0x007E/pdb/mechanical/housing.FCStd

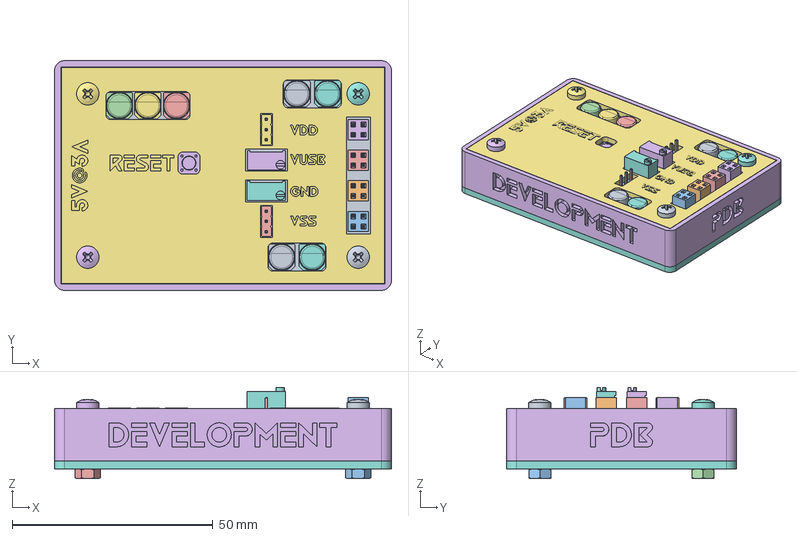
[picture p1: CAD file, 2026-11-11]
mechanical/housing.FCStd
83.9 x 57.2 x 22.7 mm
Pcb_f740
R37_R_1206_3216Metric_8dc8d8b837c7
D7_LED_1206_3216Metric_03436d3d43b0
C1_CP_Elec_63x59_ac60a408893e
J6_PinHeader_1x03_P254mm_Vertical_e7fe031d61e9
SW1_SW_SPST_PTS645_56072588c5ee
J7_PinHeader_1x03_P254mm_Vertical_64817d6dd410
C18_CP_Elec_63x59_f49aa5442a44
R33_R_1206_3216Metric_79ca62f361a1
R27_R_1206_3216Metric_e86c5854c73b
R11_R_1206_3216Metric_0498128ec142
C28_C_1206_3216Metric_f00f97c33d81
USB4110-GF-A_PART1
U13_SOIC-14_3.9x8.7mm_P1.27mm_fcffda3dd498
D11_LED_RGB_5050_6_532df4f6e047
U12_SOIC-20W_7.5x12.8mm_P1.27mm_03fbeaa8a600
C17_CP_Elec_63x59_3dc60d15017d
C14_C_1206_3216Metric_c0d112c57c42
U7_SOT-23-6_0d97033324a5
R31_R_1206_3216Metric_8311e07fb539
R32_R_0603_1608Metric_86467d0f25c6
R16_R_1206_3216Metric_bbbf9209e873
D8_LED_1206_3216Metric_1083185e3bac
C23_C_1206_3216Metric_63c05ad9d92d
C27_C_1206_3216Metric_64f8ffbf20c3
R30_R_1206_3216Metric_f399efe9705c
R7_R_1206_3216Metric_ecda7ad82412
FB1_L_1206_3216Metric_9c7c14a58714
C12_C_1206_3216Metric_c5a151fd8f46
J2_PinSocket_2x02_P2.54mm_Vertical_089ed923d5fd
R36_R_1206_3216Metric_7b1d4e33c85c
RV1_Potentiometer_Bourns_3296W_Vertical_0824b710e74b
R10_R_1206_3216Metric_e1003af8b17f
C7_C_1206_3216Metric_26ba6747aed6
C3_C_1206_3216Metric_682e178fab99
U6_SOT-23_129ab226013d
J3_PinSocket_2x02_P2.54mm_Vertical_d789eb4625c0
C21_C_1206_3216Metric_de8a52bde034
C22_CP_EIA_3528_21_Kemet_B_923ea54f02e1
C20_CP_Elec_63x59_be447e37ad13
C19_CP_Elec_63x59_ce8c8bccf6d3
D10_LED_RGB_5050_6_c19e5f31c3e7
J5_PinSocket_2x02_P2.54mm_Vertical_2282c8bdb4fb
U2_SOT-23-5_23668840369d
U4_SOT-23_160a322001ac
RV2_Potentiometer_Bourns_3296W_Vertical_1dc8002d6194
C2_CP_Elec_63x59_3be86c793b43
R35_R_0603_1608Metric_fd289fbd0296
R14_R_1206_3216Metric_f30b6a69329d
J4_PinSocket_2x02_P2.54mm_Vertical_daca4fe0ad83
F1_Fuse_1206_3216Metric_cb2e88f19b03
R25_R_1206_3216Metric_96075576e4a0
C4_CP_Elec_63x59_df56ed045cb5
U5_SOT-23-6_a3420cd51542
D9_LED_RGB_5050_6_6b2e14bdcd41
R13_R_1206_3216Metric_f45467d9409e
U8_SOT-23_cd022fe481a0
R1_R_1206_3216Metric_fea3697b2820
R24_R_1206_3216Metric_01efbf579b95
R19_R_1206_3216Metric_e2651890cbbe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
