0x007E/pdb/pcb/PDB.kicad_pcb

## KiCad design pcb/PDB.kicad_pcb (2026-10-15)

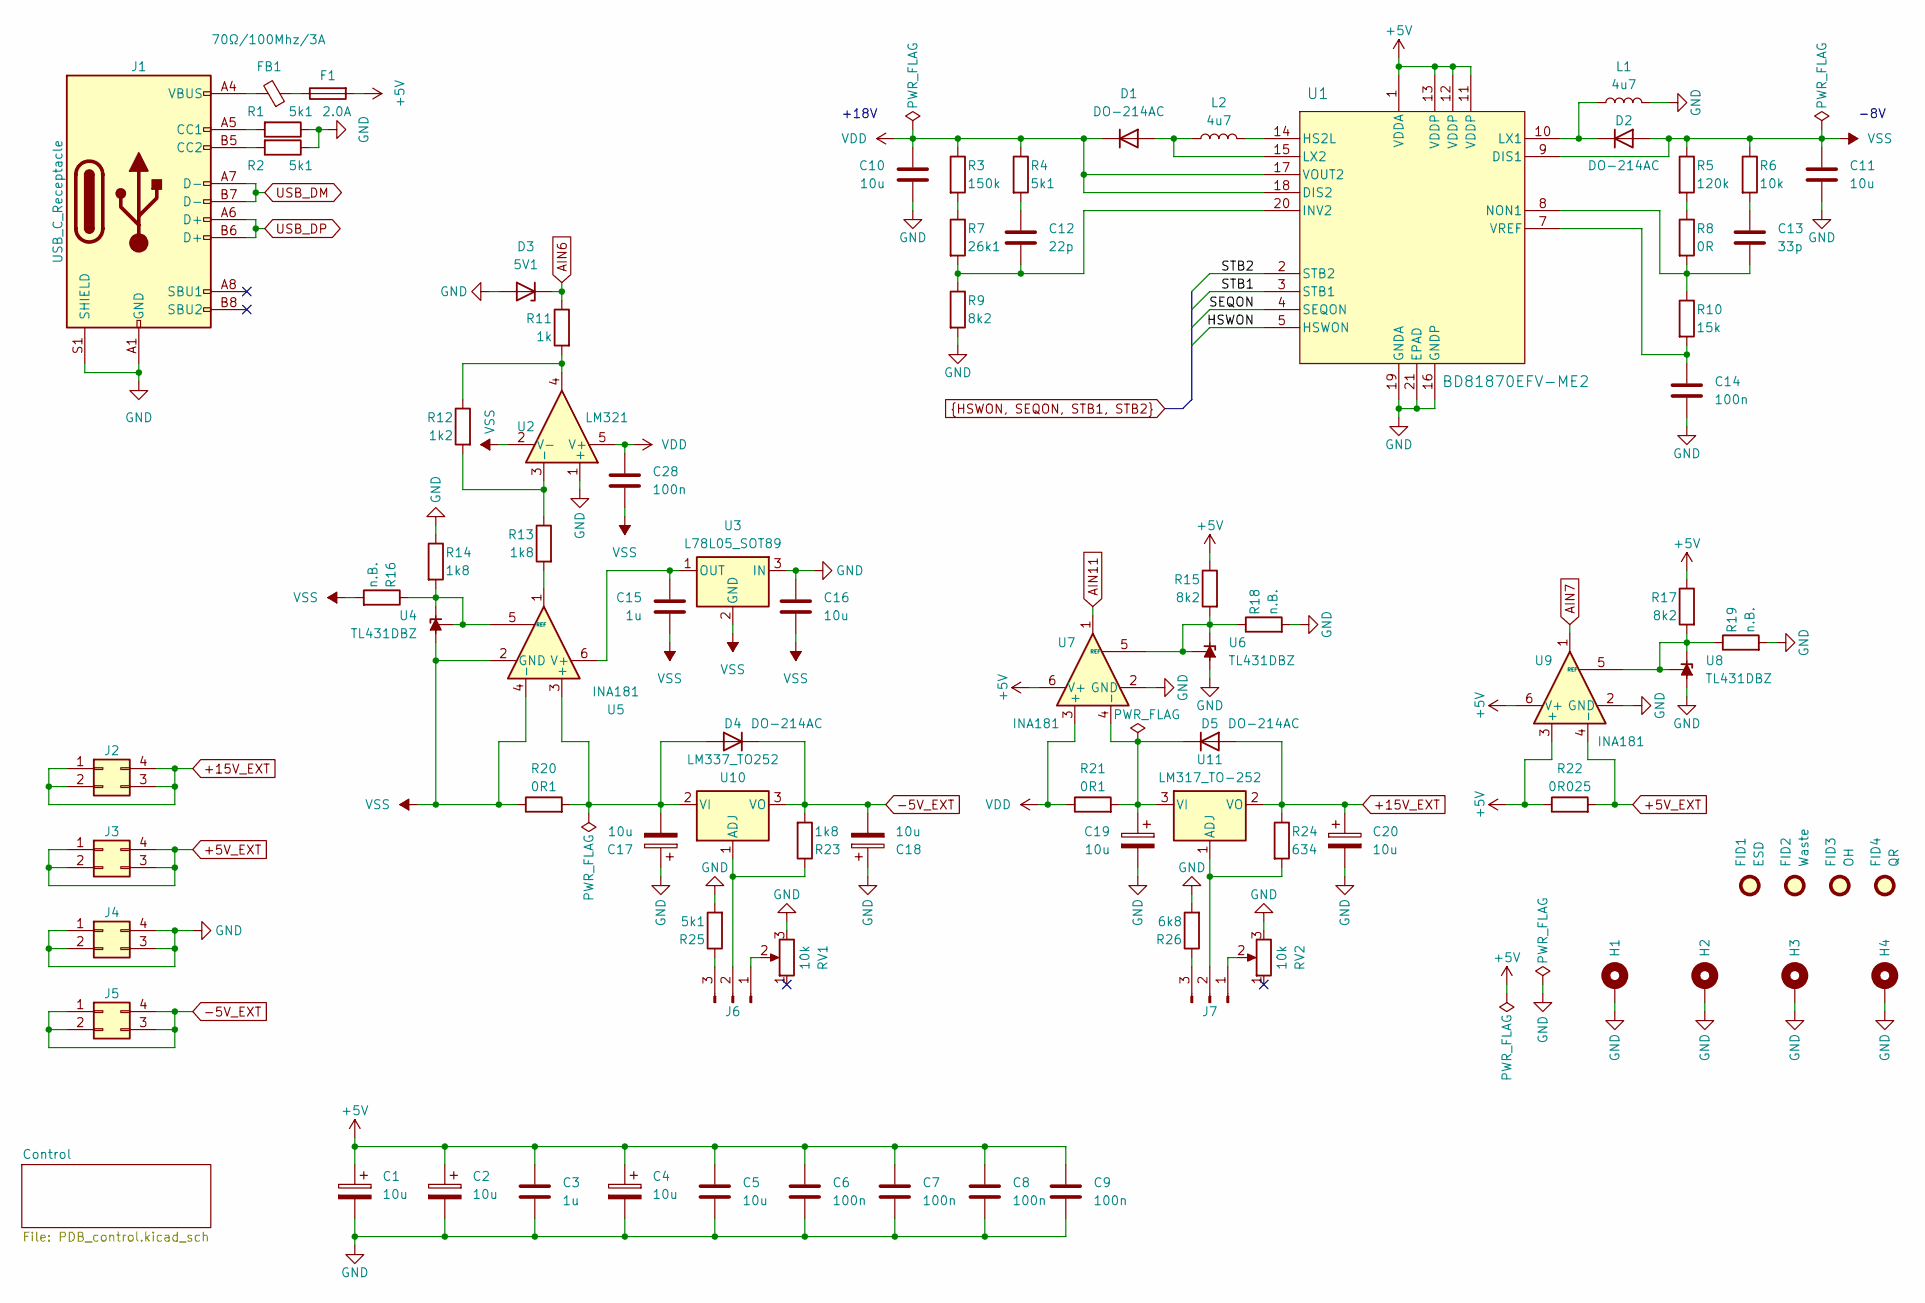
[picture p2: schematic PDB.kicad_sch, ${acronym} - ${title}]

Parts:
C1, C2, C4, C17, C18, C19, C20: 10u; CP_Elec_6.3x5.9; DigiKey 732-8545-1-ND
C3, C15: 1u; C_1206_3216Metric
C5, C10, C11, C16: 10u; C_1206_3216Metric
C6, C7, C8, C9, C14, C28: 100n; C_1206_3216Metric
C12: 22p; C_1206_3216Metric
C13: 33p; C_1206_3216Metric
D1, D2, D4, D5: DO-214AC; D_SMA
D3: 5V1; D_MiniMELF
F1: 2.0A; Fuse_1206_3216Metric
FB1: 70Ω/100Mhz/3A; L_1206_3216Metric
FID1: ESD; ESD-Logo_6.6x6mm_SilkScreen
FID2: Waste; WEEE-Logo_4.2x6mm_SilkScreen
FID3: OH; OSHW-Logo_5.7x6mm_SilkScreen
FID4: QR; QR_0x007e
H1, H2, H3, H4: MountingHole_Pad; MountingHole_3.2mm_M3_Pad
J1: USB_C_Receptacle; USB_C_Receptacle_GCT_USB4110
J2, J3, J4, J5: Conn_02x02_Counter_Clockwise; PinSocket_2x02_P2.54mm_Vertical; DigiKey 2057-RS2-04-G-ND
J6, J7: Conn_01x03_Pin; PinHeader_1x03_P2.54mm_Vertical
L1, L2: 4u7; L_Taiyo-Yuden_NR-40xx; DigiKey 587-2893-1-ND
R1, R2, R4, R25: 5k1; R_1206_3216Metric
R3: 150k; R_1206_3216Metric
R5: 120k; R_1206_3216Metric
R6: 10k; R_1206_3216Metric
R7: 26k1; R_1206_3216Metric
R8: 0R; R_1206_3216Metric
R9, R15, R17: 8k2; R_1206_3216Metric
R10: 15k; R_1206_3216Metric
R11: 1k; R_1206_3216Metric
R12: 1k2; R_1206_3216Metric
R13, R14, R23: 1k8; R_1206_3216Metric
R16, R18, R19: n.B.; R_1206_3216Metric
R20, R21: 0R1; R_2010_5025Metric; DigiKey CRM2010-FX-R100ELFCT-ND
R22: 0R025; R_2010_5025Metric
R24: 634; R_1206_3216Metric
R26: 6k8; R_1206_3216Metric
RV1, RV2: 10k; Potentiometer_Bourns_3296W_Vertical
U1: BD81870EFV-ME2; HTSSOP-20-1EP_4.4x6.5mm_P0.65mm_EP2.85x4mm; DigiKey BD81870EFV-ME2CT-ND
U2: LM321; SOT-23-5; DigiKey LM321SN3T1GOSCT-ND
U3: L78L05_SOT89; SOT-89-3
U4, U6, U8: TL431DBZ; SOT-23; DigiKey 5399-TL431CT-ND
U5, U7, U9: INA181; SOT-23-6
U10: LM337_TO252; TO-252-2; DigiKey 296-21578-1-ND
U11: LM317_TO-252; TO-252-2; DigiKey 5272-LM317MDT-EVCT-ND

Connections:
+5V: C1.1, C2.1, C3.1, C4.1, C5.1, C6.1, C7.1, C8.1, C9.1, F1.2, R15.1, R17.1, R22.1, U1.1 (VDDA), U1.11 (VDDP), U1.12 (VDDP), U1.13 (VDDP), U7.6 (V+), U9.3 (+), U9.6 (V+); also elsewhere on the board
+5V_EXT: J3.1, J3.2, J3.3, J3.4, R22.2, U9.4 (-); also elsewhere on the board
+15V_EXT: C20.1, D5.2 (A), J2.1, J2.2, J2.3, J2.4, R24.1, U11.2 (VO); also elsewhere on the board
-5V_EXT: C18.2, D4.1 (K), J5.1, J5.2, J5.3, J5.4, R23.2, U10.3 (VO); also elsewhere on the board
AIN6: D3.1 (K), R11.1; also elsewhere on the board
AIN7: U9.1; also elsewhere on the board
AIN11: U7.1; also elsewhere on the board
GND: C1.2, C2.2, C3.2, C4.2, C5.2, C6.2, C7.2, C8.2, C9.2, C10.1, C11.1, C14.1, C16.2, C17.1, C18.1, C19.2, C20.2, D3.2 (A), H1.1, H2.1, H3.1, H4.1, J1.A1 (GND), J1.A12 (GND), J1.B1 (GND), J1.B12 (GND), J1.S1 (SHIELD), J4.1, J4.2, J4.3, J4.4, L1.2, R1.1, R2.1, R9.2, R14.1, R18.2, R19.2, R25.2, R26.2, RV1.3, RV2.3, U1.16 (GNDP), U1.19 (GNDA), U1.21 (EPAD), U2.1 (+), U3.3 (IN), U6.3 (A), U7.2 (GND), U8.3 (A), U9.2 (GND); also elsewhere on the board
HSWON: U1.5 (HSWON); also elsewhere on the board
unnamed: C12.1, R4.2
unnamed: C13.2, R6.2
unnamed: D1.2 (A), L2.1, U1.15 (LX2)
unnamed: D2.1 (K), L1.1, U1.10 (LX1)
unnamed: C17.2, D4.2 (A), R20.2, U5.3 (+), U10.2 (VI)
unnamed: C19.1, D5.1 (K), R21.2, U7.4 (-), U11.3 (VI)
unnamed: F1.1, FB1.1
unnamed: FB1.2, J1.A4 (VBUS), J1.A9 (VBUS), J1.B4 (VBUS), J1.B9 (VBUS)
unnamed: J1.A5 (CC1), R1.2
unnamed: J1.B5 (CC2), R2.2
unnamed: J6.1, RV1.2
unnamed: J6.2, R23.1, U10.1 (ADJ)
unnamed: J6.3, R25.1
unnamed: J7.1, RV2.2
unnamed: J7.2, R24.2, U11.1 (ADJ)
unnamed: J7.3, R26.1
unnamed: R3.2, R7.1
unnamed: R5.2, R8.1
unnamed: R11.2, R12.1, U2.4
unnamed: R13.2, U5.1
unnamed: L2.2, U1.14 (HS2L)
unnamed: C12.2, R7.2, R9.1, U1.20 (INV2)
unnamed: C13.1, R8.2, R10.1, U1.8 (NON1)
unnamed: C14.2, R10.2, U1.7 (VREF)
unnamed: R12.2, R13.1, U2.3 (-)
unnamed: C15.2, U3.1 (OUT), U5.6 (V+)
unnamed: R14.2, R16.1, U4.1 (K), U4.2 (REF), U5.5 (REF)
unnamed: R15.2, R18.1, U6.1 (K), U6.2 (REF), U7.5 (REF)
unnamed: R17.2, R19.1, U8.1 (K), U8.2 (REF), U9.5 (REF)
SEQON: U1.4 (SEQON); also elsewhere on the board
STB1: U1.3 (STB1); also elsewhere on the board
STB2: U1.2 (STB2); also elsewhere on the board
USB_DM: J1.A7 (D-), J1.B7 (D-); also elsewhere on the board
USB_DP: J1.A6 (D+), J1.B6 (D+); also elsewhere on the board
VDD: C10.2, C28.1, D1.1 (K), R3.1, R4.1, R21.1, U1.17 (VOUT2), U1.18 (DIS2), U2.5 (V+), U7.3 (+)
VSS: C11.2, C15.1, C16.1, C28.2, D2.2 (A), R5.1, R6.1, R16.2, R20.1, U1.9 (DIS1), U2.2 (V-), U3.2 (GND), U4.3 (A), U5.2 (GND), U5.4 (-)

Notes on the sheet:
-8V
+18V

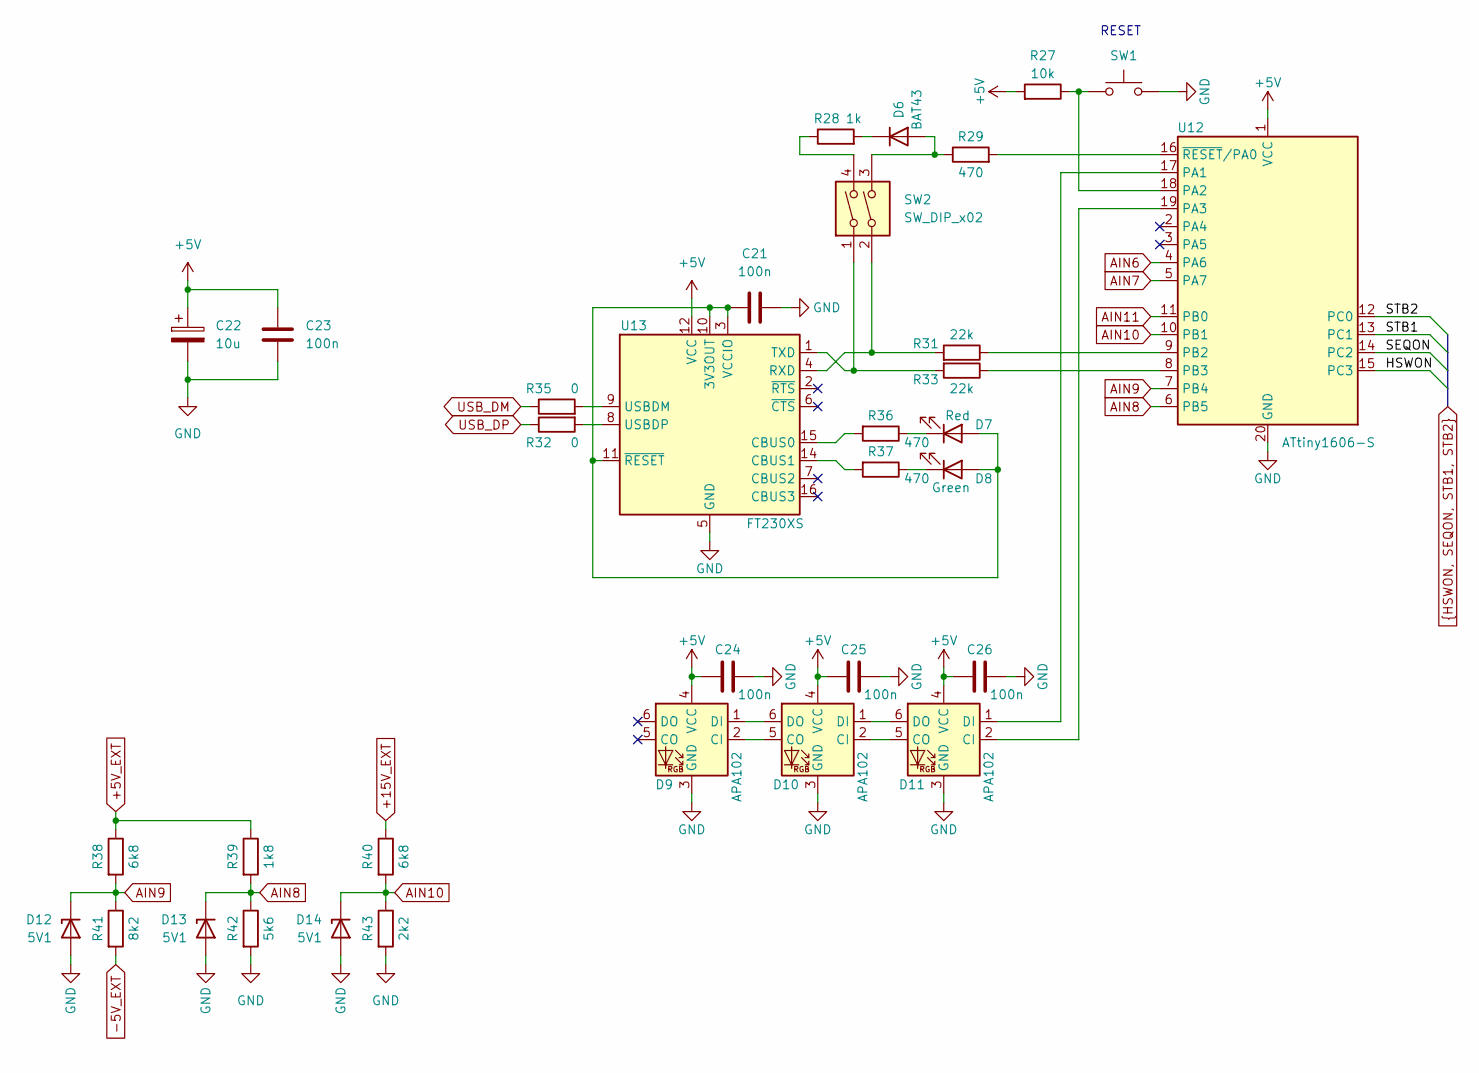
[picture p3: schematic PDB_control.kicad_sch, ${acronym} - ${title}]

Parts:
C21, C23, C24, C25, C26: 100n; C_1206_3216Metric
C22: 10u; CP_EIA-3528-21_Kemet-B
D6: BAT43; D_MiniMELF
D7: Red; LED_1206_3216Metric
D8: Green; LED_1206_3216Metric
D9, D10, D11: APA102; LED_RGB_5050-6
D12, D13, D14: 5V1; D_MiniMELF
R27: 10k; R_1206_3216Metric
R28: 1k; R_1206_3216Metric
R29, R36, R37: 470; R_1206_3216Metric
R31, R33: 22k; R_1206_3216Metric
R32, R35: 0; R_0603_1608Metric; DigiKey RMCF0603ZT0R00CT-ND
R38, R40: 6k8; R_1206_3216Metric
R39: 1k8; R_1206_3216Metric
R41: 8k2; R_1206_3216Metric
R42: 5k6; R_1206_3216Metric
R43: 2k2; R_1206_3216Metric
SW1: SW_Push; SW_SPST_PTS645
SW2: SW_DIP_x02; SW_DIP_SPSTx02_Slide_6.7x6.64mm_W8.61mm_P2.54mm_LowProfile
U12: ATtiny1606-S; SOIC-20W_7.5x12.8mm_P1.27mm
U13: FT230XS; SSOP-16_3.9x4.9mm_P0.635mm

Connections:
+5V: C22.1, C23.1, C24.2, C25.2, C26.2, D9.4 (VCC), D10.4 (VCC), D11.4 (VCC), R27.2, U12.1 (VCC), U13.12 (VCC); also elsewhere on the board
+5V_EXT: R38.1, R39.1; also elsewhere on the board
+15V_EXT: R40.1; also elsewhere on the board
-5V_EXT: R41.2; also elsewhere on the board
AIN6: U12.4 (PA6); also elsewhere on the board
AIN7: U12.5 (PA7); also elsewhere on the board
AIN8: D13.1 (K), R39.2, R42.1, U12.6 (PB5)
AIN9: D12.1 (K), R38.2, R41.1, U12.7 (PB4)
AIN10: D14.1 (K), R40.2, R43.1, U12.10 (PB1)
AIN11: U12.11 (PB0); also elsewhere on the board
GND: C21.2, C22.2, C23.2, C24.1, C25.1, C26.1, D9.3 (GND), D10.3 (GND), D11.3 (GND), D12.2 (A), D13.2 (A), D14.2 (A), R42.2, R43.2, SW1.1, U12.20 (GND), U13.5 (GND), U13.13 (GND); also elsewhere on the board
HSWON: U12.15 (PC3); also elsewhere on the board
unnamed: D6.2 (A), R29.1, SW2.3
unnamed: D6.1 (K), R28.2
unnamed: C21.1, D7.2 (A), D8.2 (A), U13.3 (VCCIO), U13.10 (3V3OUT), U13.11 (~RESET)
unnamed: D7.1 (K), R36.1
unnamed: D8.1 (K), R37.1
unnamed: D10.2 (CI), D11.5 (CO)
unnamed: D9.2 (CI), D10.5 (CO)
unnamed: D10.1 (DI), D11.6 (DO)
unnamed: D9.1 (DI), D10.6 (DO)
unnamed: D11.2 (CI), U12.19 (PA3)
unnamed: D11.1 (DI), U12.17 (PA1)
unnamed: R28.1, SW2.4
unnamed: R27.1, SW1.2, U12.18 (PA2)
unnamed: R31.1, U12.9 (PB2)
unnamed: R33.1, U12.8 (PB3)
unnamed: R29.2, U12.16 (~RESET/PA0)
unnamed: R36.2, U13.15 (CBUS0)
unnamed: R37.2, U13.14 (CBUS1)
unnamed: R31.2, SW2.2, U13.4 (RXD)
unnamed: R33.2, SW2.1, U13.1 (TXD)
unnamed: R35.2, U13.9 (USBDM)
unnamed: R32.2, U13.8 (USBDP)
SEQON: U12.14 (PC2); also elsewhere on the board
STB1: U12.13 (PC1); also elsewhere on the board
STB2: U12.12 (PC0); also elsewhere on the board
USB_DM: R35.1; also elsewhere on the board
USB_DP: R32.1; also elsewhere on the board

Notes on the sheet:
RESET

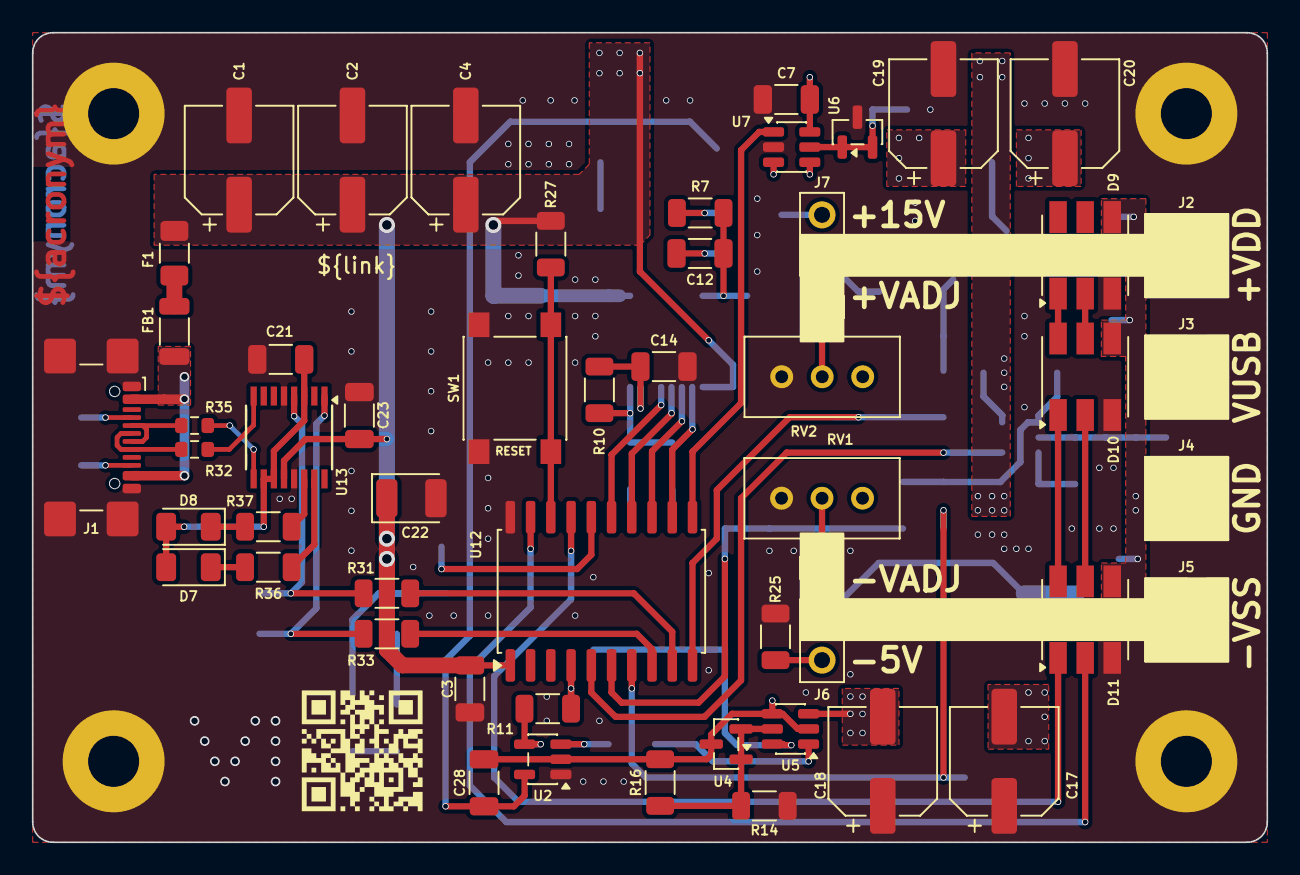
[picture p4: board PDB.kicad_pcb from above]

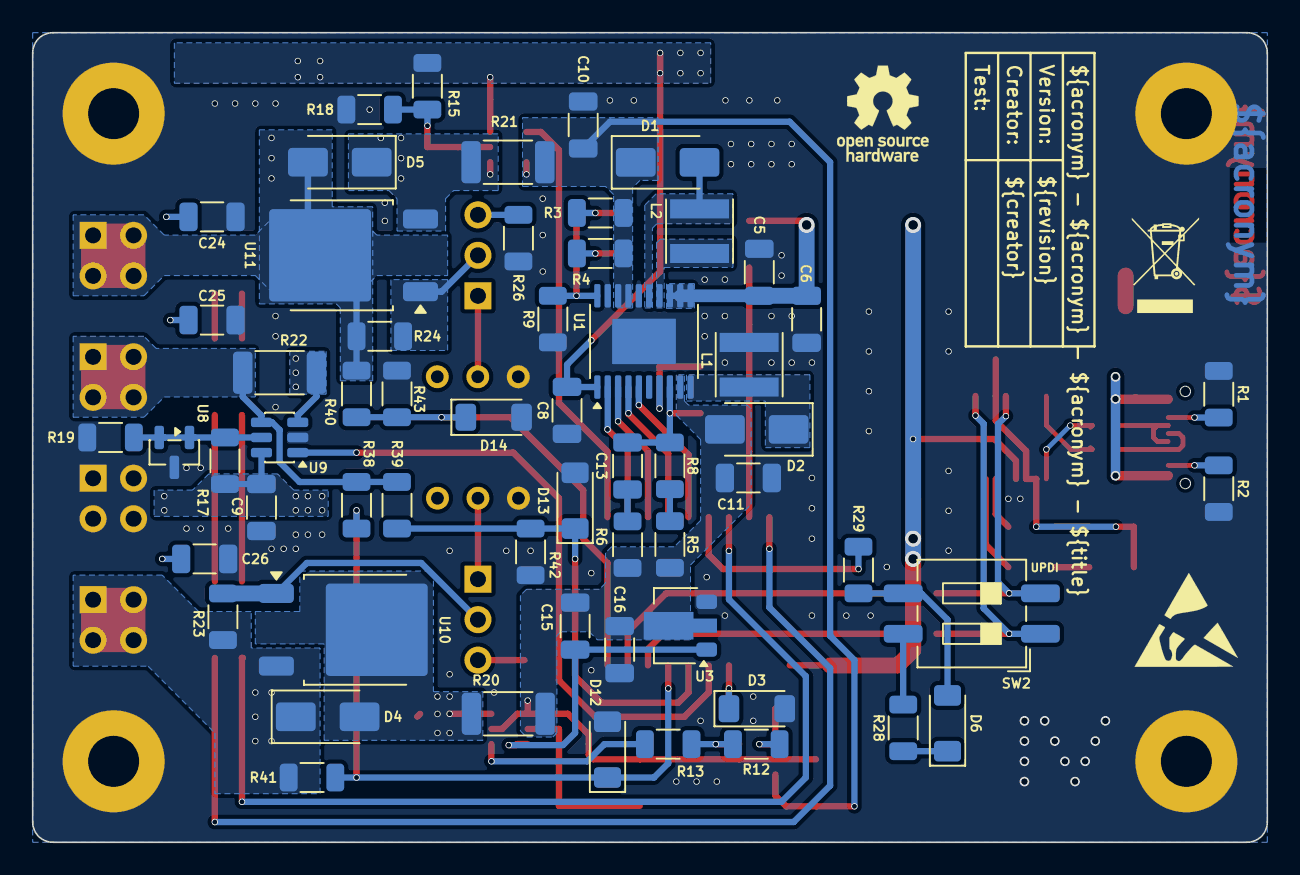
[picture p5: board PDB.kicad_pcb from below]

Board: 2 copper layers, 77.5 x 50.8 mm, 118 parts (61 on the bottom side), 70 nets.
