0x007E/pdb/(commit log)

2026-05-04 Add pcb layout
    [PDB.kicad_pcb, PDB.kicad_sch, PDB_control.kicad_sch]
2026-05-05 Add mechanical parts
    [housing.FCStd]
2026-05-27 Update to KiCAD 9
    [PDB.kicad_pcb, PDB.kicad_sch, PDB_control.kicad_sch]
2026-05-27 Add dimensioning
    [PDB.kicad_pcb]
2026-06-04 Change MCP2221A to FT230X
    [PDB.kicad_pcb, PDB_control.kicad_sch]
2026-06-05 Optimize +3V3 signal
    [PDB.kicad_pcb, PDB_control.kicad_sch]
2026-10-06 Fix wrong part-id
    [PDB.kicad_pcb, PDB.kicad_sch]
2026-10-06 Silkscreen text optimization
    [PDB.kicad_pcb]
2026-10-13 Modify voltage divider and silkscreen
2026-10-15 Update +15V voltage divider resistor values
2026-11-11 Optimize housing height
