0x007E/pdb/(notices)

Notices in the files:
parts and their libraries:
license: CC BY-NC-SA 4.0
